open-320-neo/korry-switches/readme.md

---
title: Korry Switches
author: Samuel Hafen
---

# Korry Knöpfe

Damit man das Gefühl bekommt wirklich in einem Cockpit zu sitzen, ist es wichtig dass die Knöpfe realistisch aussehen und auch funktionieren. Wir möchten dass sie einfach im 3d Drucker herstellbar sind, und modular, damit man nicht für jedes panel einen spezifischen print machen muss.

## Dimensionen

Die Dimensionen wurden aud dem originalen Korry Datenblatt abgeschaut, und danach in metrische werte konvertiert.

## Linsen

Die Linsen, auf welchen die texte sichtbar sind, werden mit Acrylglas und dem Lasercutter realisiert.
