open-320-neo/korry-switches/korry-389/3d-print/button.FCStd

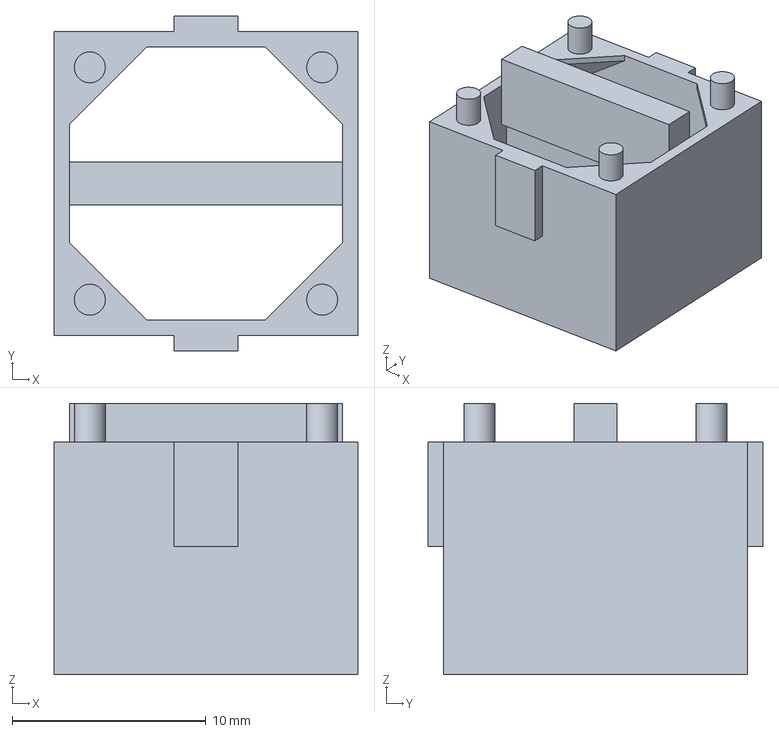
[picture p6: CAD file, 2026-03-18]
korry-389/3d-print/button.FCStd
15.7 x 17.3 x 14.0 mm
