open-320-neo/korry-switches/korry-389/lenses/fault.dxf

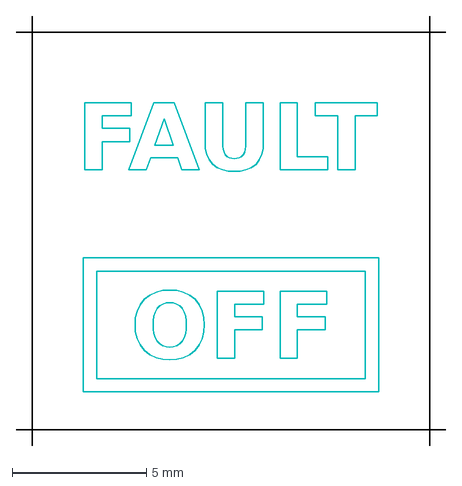
[picture p7: CAD file, 2026-08-24]
korry-389/lenses/fault.dxf
16.0 x 16.0 mm
