open-320-neo/korry-switches/korry-389/3d-print/housing.3mf

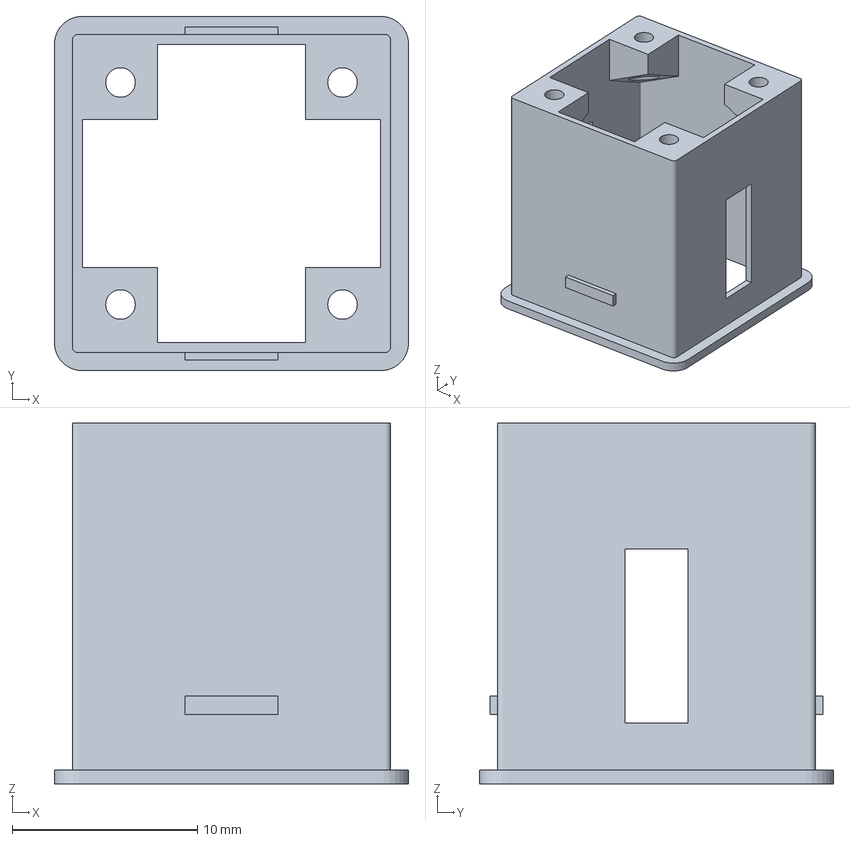
[picture p8: CAD file, 2025-05-02]
korry-389/3d-print/housing.3mf
19.1 x 19.1 x 19.5 mm
