open-320-neo/korry-switches/korry-389/lenses/lens-template.dxf

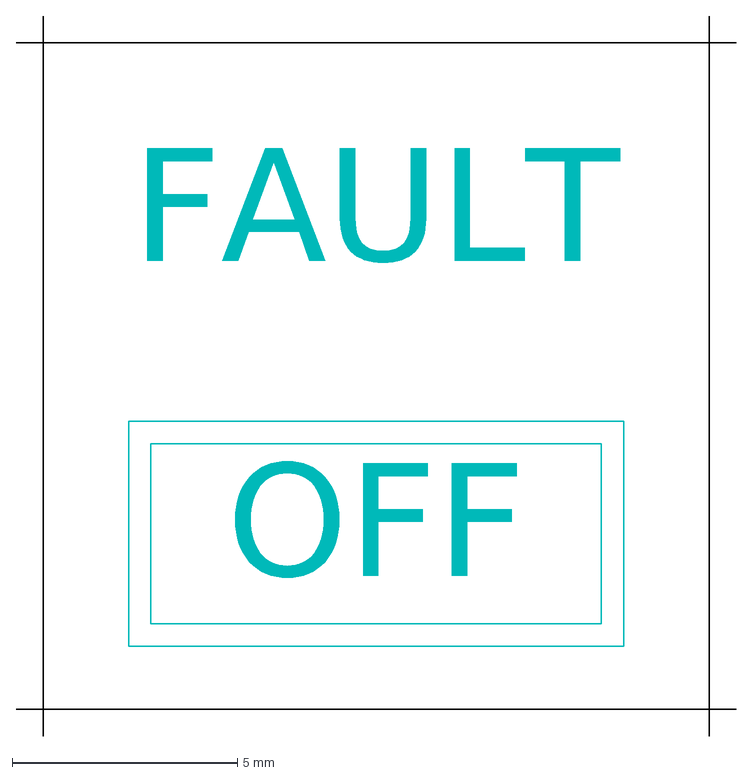
[picture p9: CAD file, 2026-08-24]
korry-389/lenses/lens-template.dxf
FAULT
OFF
