open-320-neo/korry-switches/(list of files, cad)

Other CAD files:
korry-389/3d-print/button.3mf
