open-320-neo/korry-switches/korry-389/pcb/schematic.pdf

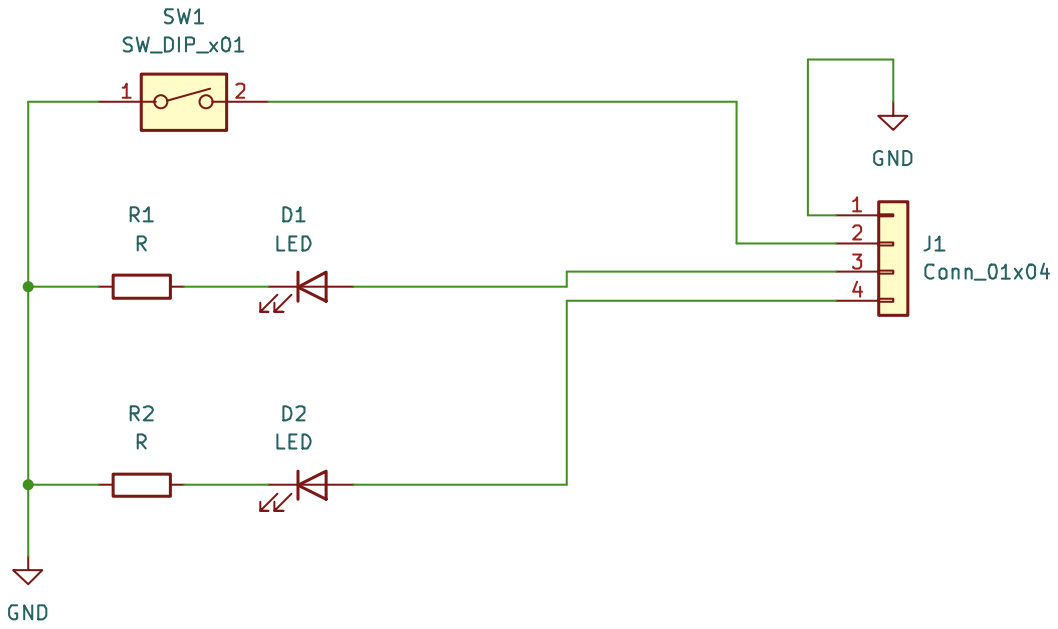
[picture p10: page 1]
