open-320-neo/korry-switches/controler/pcb/controller.kicad_pcb

## KiCad design controler/pcb/controller.kicad_pcb (2025-07-12)

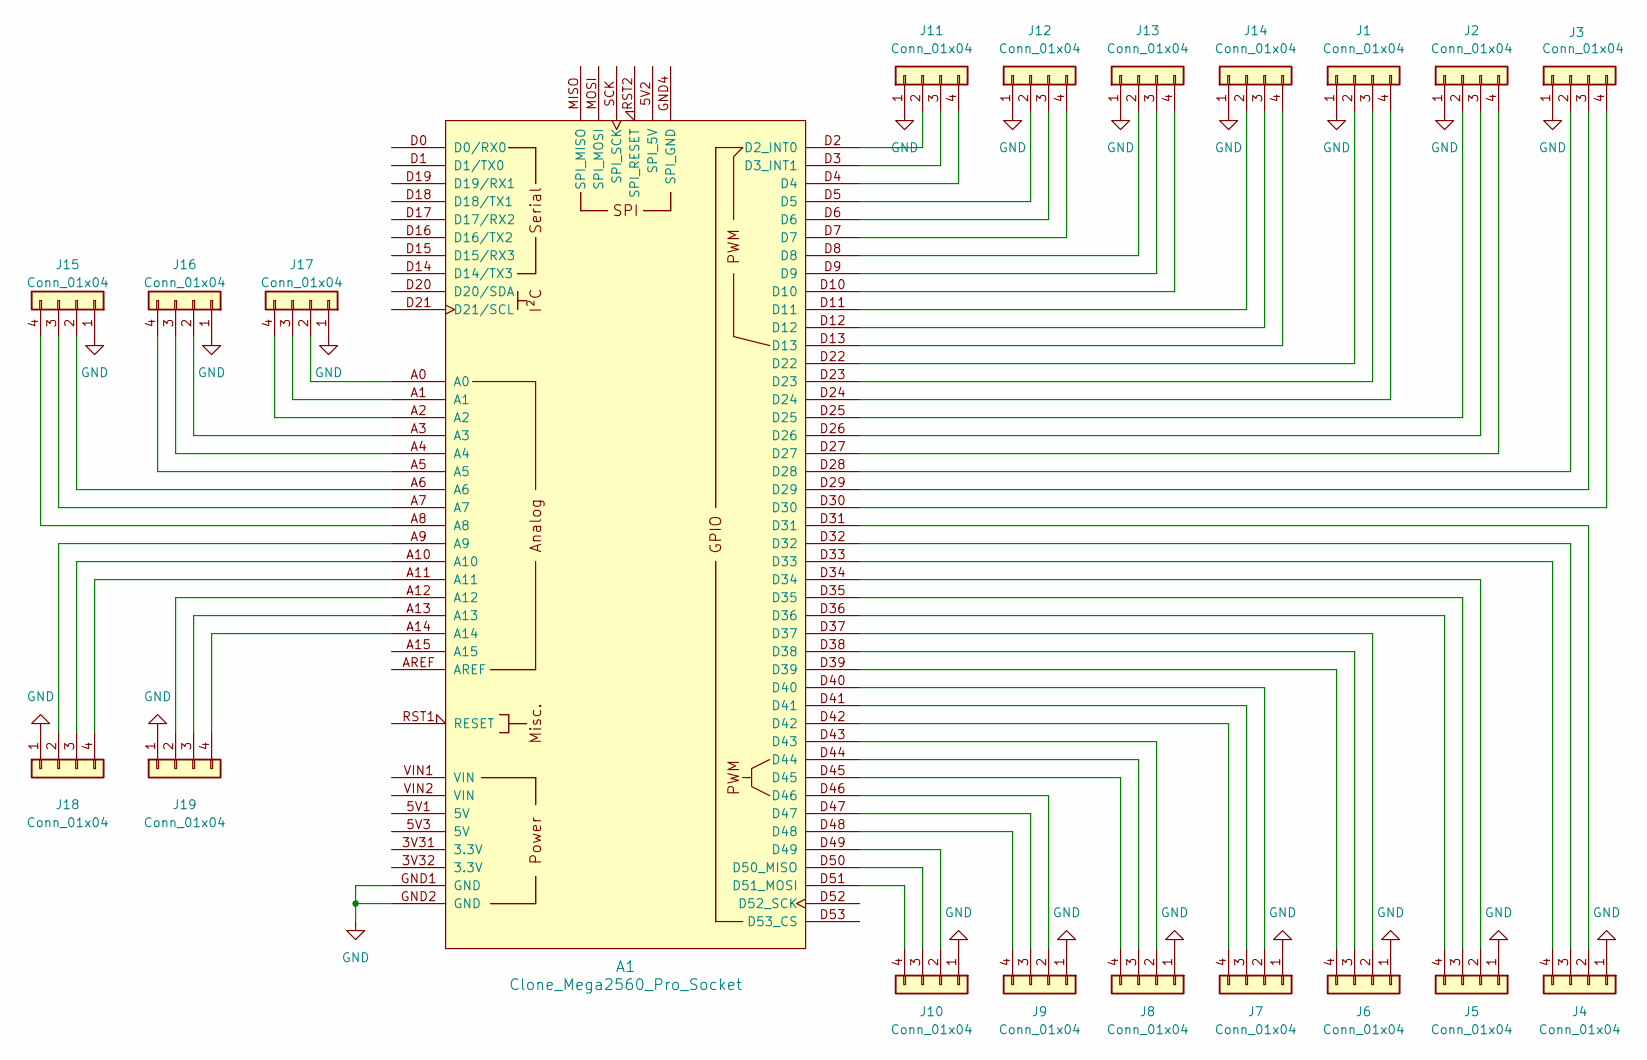
[picture p11: schematic controller.kicad_sch]

Parts:
A1: Clone_Mega2560_Pro_Socket
J1, J2, J3, J4, J5, J6, J7, J8, J9, J10, J11, J12, J13, J14, J15, J16, J17, J18, J19: Conn_01x04; JST_ZH_B4B-ZR_1x04_P1.50mm_Vertical

Connections:
GND: A1.GND1 (GND), A1.GND2 (GND), J1.1, J2.1, J3.1, J4.1, J5.1, J6.1, J7.1, J8.1, J9.1, J10.1, J11.1, J12.1, J13.1, J14.1, J15.1, J16.1, J17.1, J18.1, J19.1
unnamed: A1.D2 (D2_INT0), J11.2
unnamed: A1.D3 (D3_INT1), J11.3
unnamed: A1.D50 (D50_MISO), J10.3
unnamed: A1.D51 (D51_MOSI), J10.4
unnamed: A1.D22, J1.2
unnamed: A1.D23, J1.3
unnamed: A1.D24, J1.4
unnamed: A1.D25, J2.2
unnamed: A1.D26, J2.3
unnamed: A1.D27, J2.4
unnamed: A1.D28, J3.2
unnamed: A1.D29, J3.3
unnamed: A1.D30, J3.4
unnamed: A1.D31, J4.2
unnamed: A1.D32, J4.3
unnamed: A1.D33, J4.4
unnamed: A1.D34, J5.2
unnamed: A1.D35, J5.3
unnamed: A1.D36, J5.4
unnamed: A1.D37, J6.2
unnamed: A1.D38, J6.3
unnamed: A1.D39, J6.4
unnamed: A1.D40, J7.2
unnamed: A1.D41, J7.3
unnamed: A1.D42, J7.4
unnamed: A1.D43, J8.2
unnamed: A1.D44, J8.3
unnamed: A1.D45, J8.4
unnamed: A1.D46, J9.2
unnamed: A1.D47, J9.3
unnamed: A1.D48, J9.4
unnamed: A1.D49, J10.2
unnamed: A1.D4, J11.4
unnamed: A1.D5, J12.2
unnamed: A1.D6, J12.3
unnamed: A1.D7, J12.4
unnamed: A1.D8, J13.2
unnamed: A1.D9, J13.3
unnamed: A1.D10, J13.4
unnamed: A1.D11, J14.2
unnamed: A1.D12, J14.3
unnamed: A1.D13, J14.4
unnamed: A1.A6, J15.2
unnamed: A1.A7, J15.3
unnamed: A1.A8, J15.4
unnamed: A1.A3, J16.2
unnamed: A1.A4, J16.3
unnamed: A1.A5, J16.4
unnamed: A1.A0, J17.2
unnamed: A1.A1, J17.3
unnamed: A1.A2, J17.4
unnamed: A1.A9, J18.2
unnamed: A1.A10, J18.3
unnamed: A1.A11, J18.4
unnamed: A1.A12, J19.2
unnamed: A1.A13, J19.3
unnamed: A1.A14, J19.4

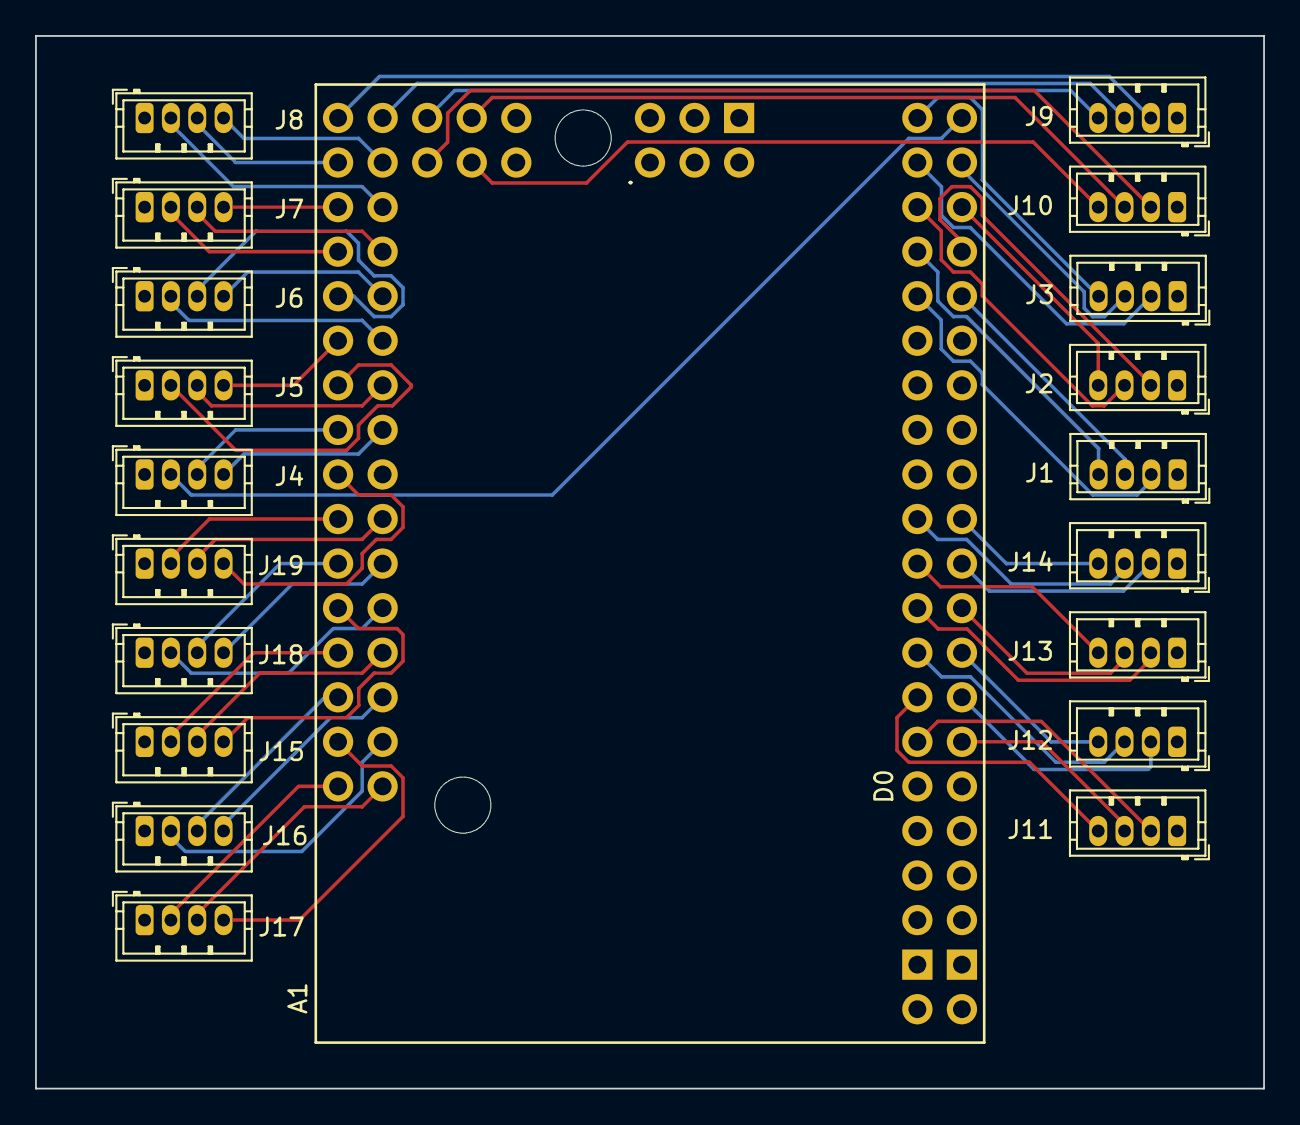
[picture p12: board controller.kicad_pcb from above]

Board: 2 copper layers, 70.0 x 60.0 mm, 20 parts (0 on the bottom side), 58 nets.
