open-320-neo/korry-switches/korry-389/pcb/button-pcb.kicad_pcb

## KiCad design korry-389/pcb/button-pcb.kicad_pcb (2025-07-12)

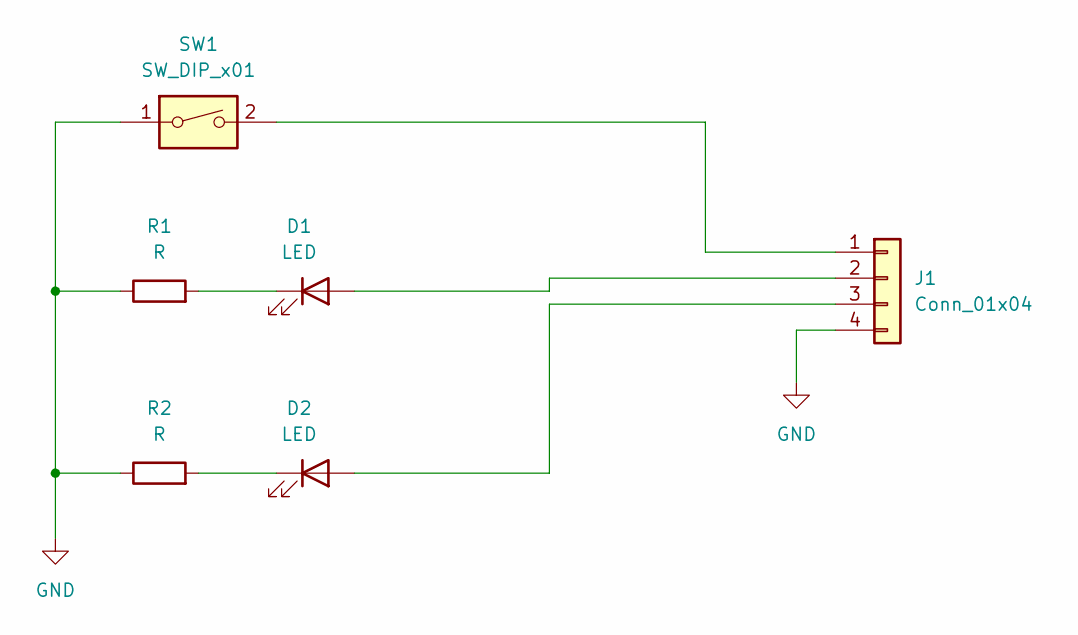
[picture p13: schematic button-pcb.kicad_sch]

Parts:
D1, D2: LED; LED_D3.0mm
J1: Conn_01x04; JST_ZH_B4B-ZR_1x04_P1.50mm_Vertical
R1, R2: R; R_1206_3216Metric_Pad1.30x1.75mm_HandSolder
SW1: SW_DIP_x01; button-6mm-small

Connections:
GND: J1.4, R1.1, R2.1, SW1.1
unnamed: D1.2 (A), J1.2
unnamed: D1.1 (K), R1.2
unnamed: D2.2 (A), J1.3
unnamed: D2.1 (K), R2.2
unnamed: J1.1, SW1.2

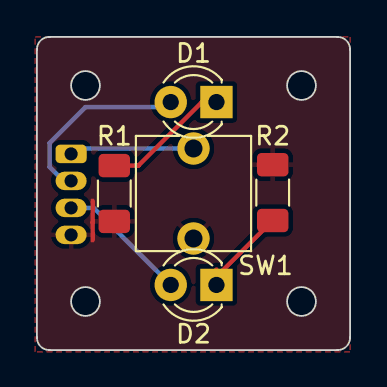
[picture p14: board button-pcb.kicad_pcb from above]

Board: 2 copper layers, 17.4 x 17.4 mm, 6 parts (1 on the bottom side), 6 nets.
