open-320-neo/korry-switches/(commit log)

2024-10-30 adding scad file
    [button.scad]
2024-10-30 adding kicad project
    [button-pcb.kicad_pcb, button-pcb.kicad_sch, button-pcb.step, button-pcb.stl]
2025-05-02 adding 3D files of current batch
    [button.3mf, button.stl, housing.3mf]
2025-05-02 adding pdf filter
2025-05-02 printing german docs to file
2025-05-02 adding lens
    [button.3mf, button.scad, button.stl]
2025-05-28 changing pcb and creating gerber files
    [button-pcb-B_Cu.gbr, button-pcb-B_Mask.gbr, button-pcb-B_Paste.gbr, button-pcb-B_Silkscreen.gbr, button-pcb-Edge_Cuts.gbr, button-pcb-F_Cu.gbr, button-pcb-F_Mask.gbr, button-pcb-F_Paste.gbr]
2025-05-28 creating new project for korry switch controller
    [controller.kicad_pcb, controller.kicad_sch]
2025-07-10 adding controller board pcb
    [button-pcb.kicad_pcb, button-pcb.kicad_sch, controller.kicad_pcb, controller.kicad_sch]
2025-07-12 preparing for Production
    [button-pcb-B_Cu.gbr, button-pcb-B_Mask.gbr, button-pcb-B_Paste.gbr, button-pcb-B_Silkscreen.gbr, button-pcb-Edge_Cuts.gbr, button-pcb-F_Cu.gbr, button-pcb-F_Mask.gbr, button-pcb-F_Paste.gbr]
2026-03-18 cleaning up data
    [button-0.25-prepared.3mf, button-3-Body.3mf, button-3.FCStd, button-Body.3mf, button-Fusion002.3mf, button-PREPARED.3mf, button-multi-new.3mf, button-multi.3mf]
2026-03-18 Revert "cleaning up data"
    This reverts commit 15c657068ddfbee86325a78b1c3589183bd3c978.
    [button-0.25-prepared.3mf, button-3-Body.3mf, button-3.FCStd, button-Body.3mf, button-Fusion002.3mf, button-PREPARED.3mf, button-multi-new.3mf, button-multi.3mf]
2026-03-18 adding documentation about controller
    [controller.kicad_pcb, controller.kicad_sch]
2026-08-24 adding documentation for Korry-389
    [fault.dxf, lens-template.dxf]
